kamyarkazremi/esp32-cc1101-rf-bridge/enclosure/rf_bridge_print_plate.stl

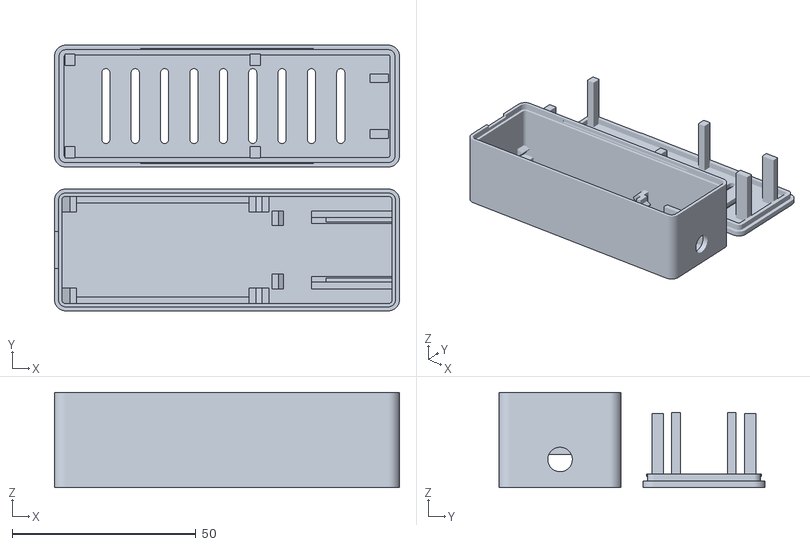
[picture p2: CAD file, 2026-10-26]
enclosure/rf_bridge_print_plate.stl
94.0 x 72.4 x 26.0
