kamyarkazremi/esp32-cc1101-rf-bridge/enclosure/rf_bridge_case_bottom.stl

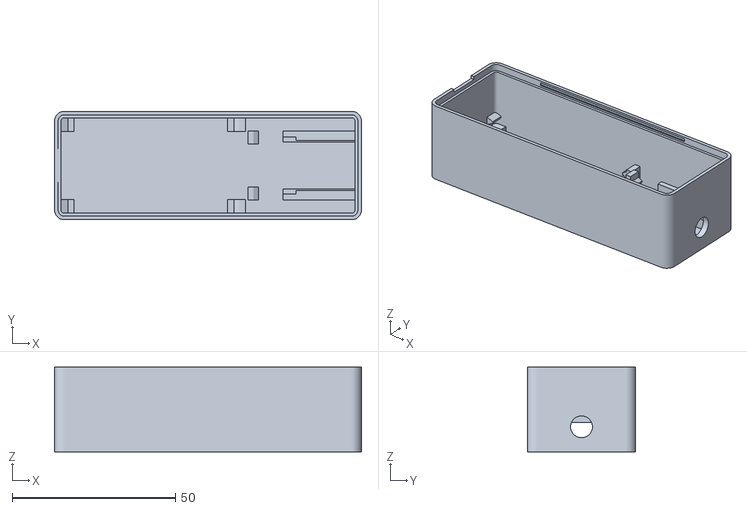
[picture p3: CAD file, 2026-10-26]
enclosure/rf_bridge_case_bottom.stl
94.0 x 33.2 x 26.0
