kamyarkazremi/esp32-cc1101-rf-bridge/enclosure/rf_bridge_case_lid.stl

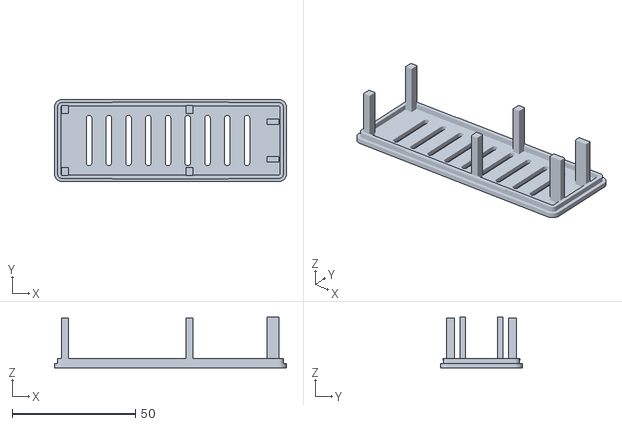
[picture p4: CAD file, 2026-10-26]
enclosure/rf_bridge_case_lid.stl
94.0 x 33.2 x 20.5
