kamyarkazremi/esp32-cc1101-rf-bridge/(commit log)

2026-10-26 Initial commit: ESP32 + CC1101 433.92 MHz RF Bridge for Home Assistant
2026-10-26 Add 3D-printable snap-fit enclosure (OpenSCAD + STL files + preview)
    [esp32_cc1101_enclosure.scad, rf_bridge_case_bottom.stl, rf_bridge_case_lid.stl, rf_bridge_print_plate.stl]
2026-10-26 Update enclosure v2: Center-spine ESP32 pedestal with 21mm Dupont pin trenches & open-back CC1101 cradle
    [esp32_cc1101_enclosure.scad, rf_bridge_case_bottom.stl, rf_bridge_case_lid.stl, rf_bridge_print_plate.stl]
2026-10-26 Update enclosure v3: Minimal-volume narrow in-line stick (94x33.2x26mm, face-down ESP32 + rear SMA port)
    [esp32_cc1101_enclosure.scad, rf_bridge_case_bottom.stl, rf_bridge_case_lid.stl, rf_bridge_print_plate.stl]
2026-10-26 Update enclosure v4: Positive mechanical locking (snap-in PCB hooks, C-channel rails, and lid hold-down pillars)
    [esp32_cc1101_enclosure.scad, rf_bridge_case_bottom.stl, rf_bridge_case_lid.stl, rf_bridge_print_plate.stl]
